fab4U/Hacklace2/documentation/Hacklace2_Assembly.pdf

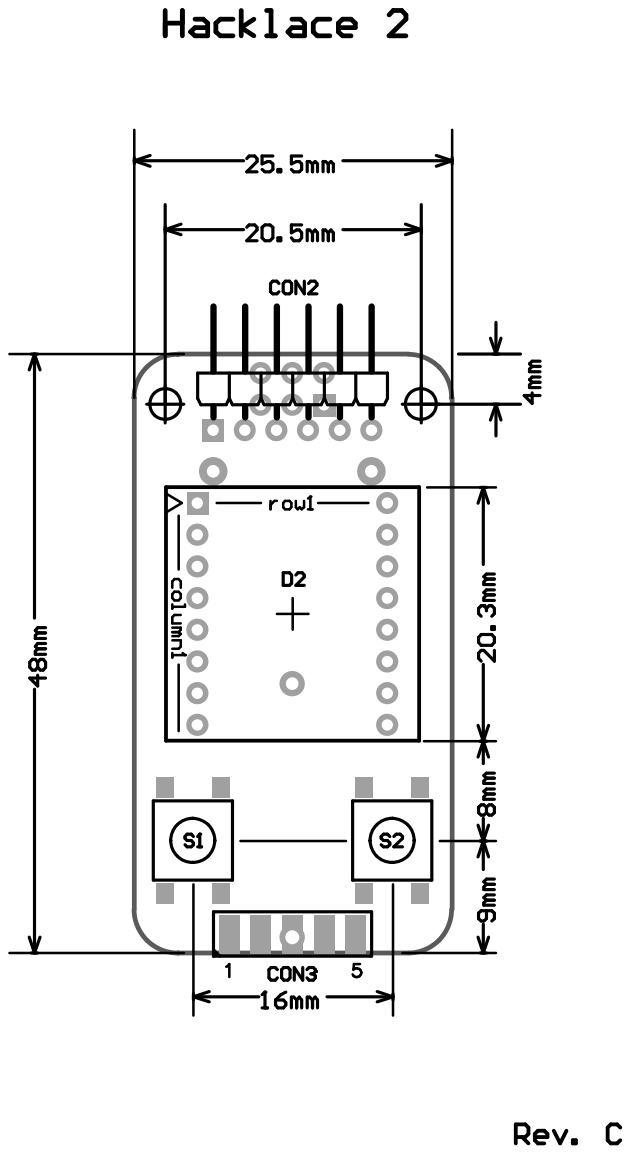
[picture p53: page 1]

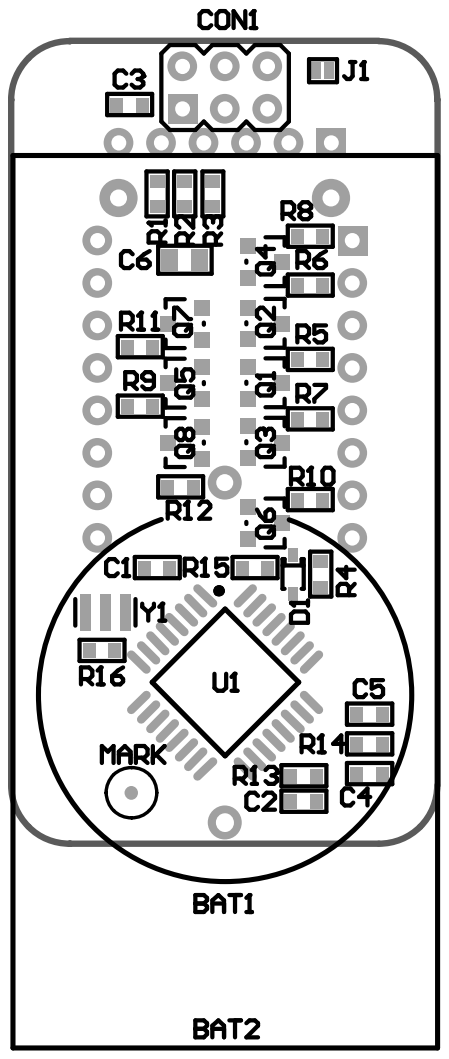
[picture p54: page 2]
