fab4U/Hacklace2/documentation/Hacklace2_Schematic.pdf

## ISP-Port Supply

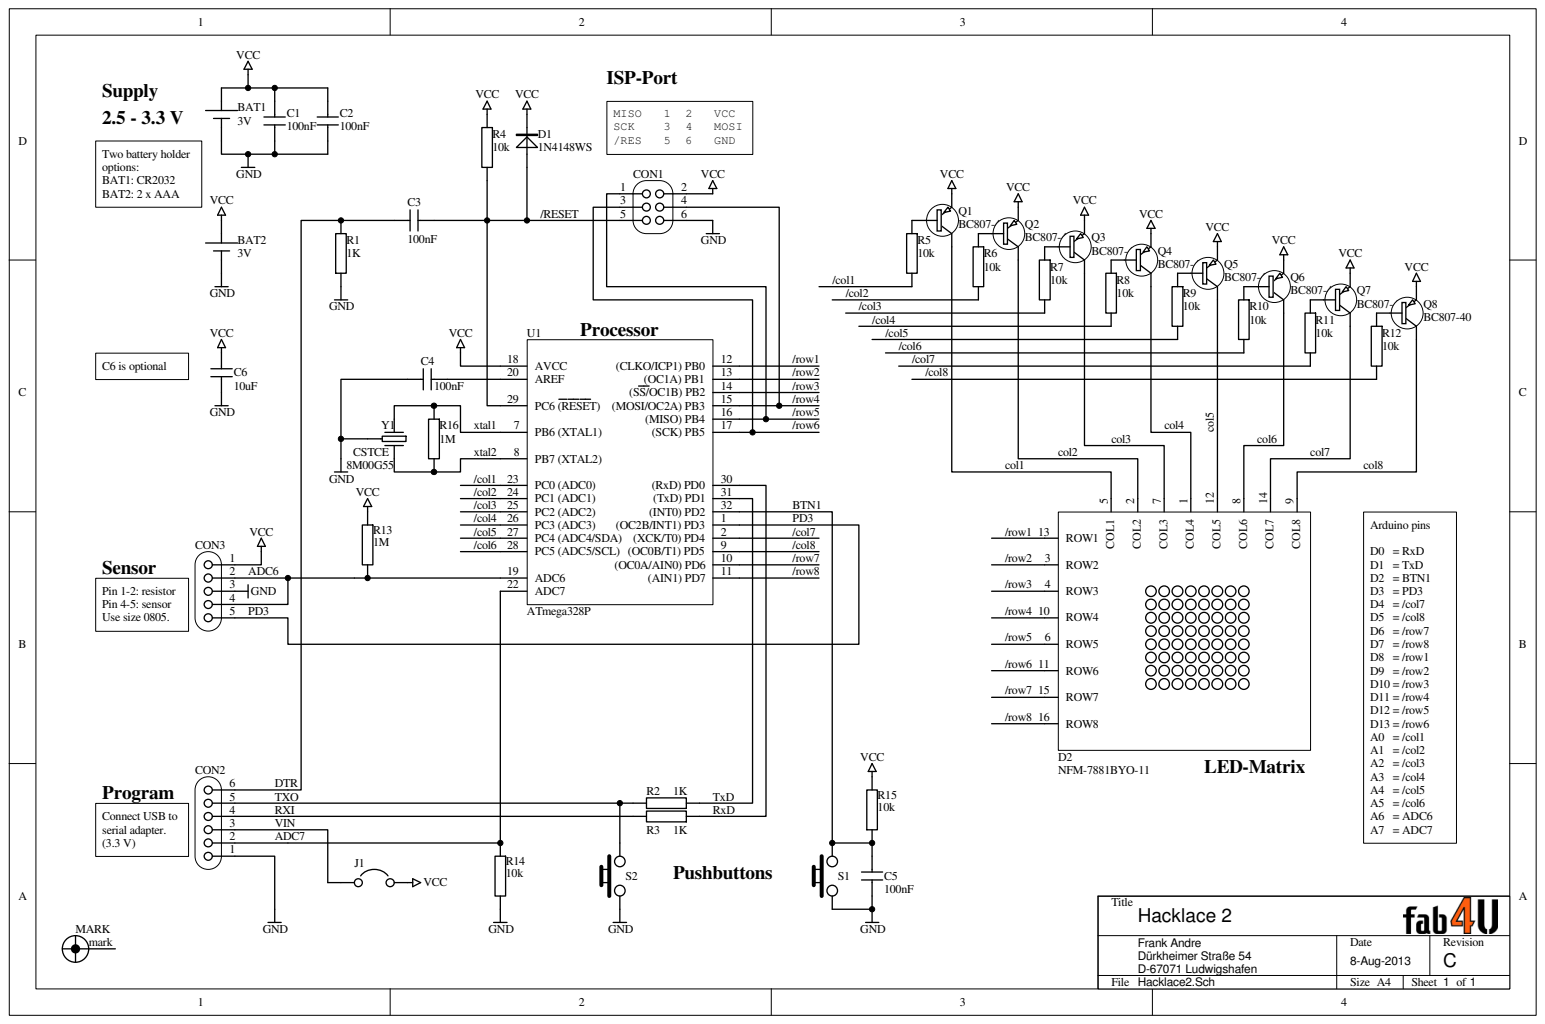
[picture p55: page 1]
