fab4U/Hacklace2/(notices)

Notices in the files:
HL_Hello_World2/HL_Hello_World2.ino:
Copyright 2015: Frank Andre
License: see "license.md"
Hacklace_Games/HL_AppRegistry.h:
Copyright 2013: Frank Andre
